ghoshpreetam18/smart_meter_using_arduino/IMG_20180408_132821.jpg

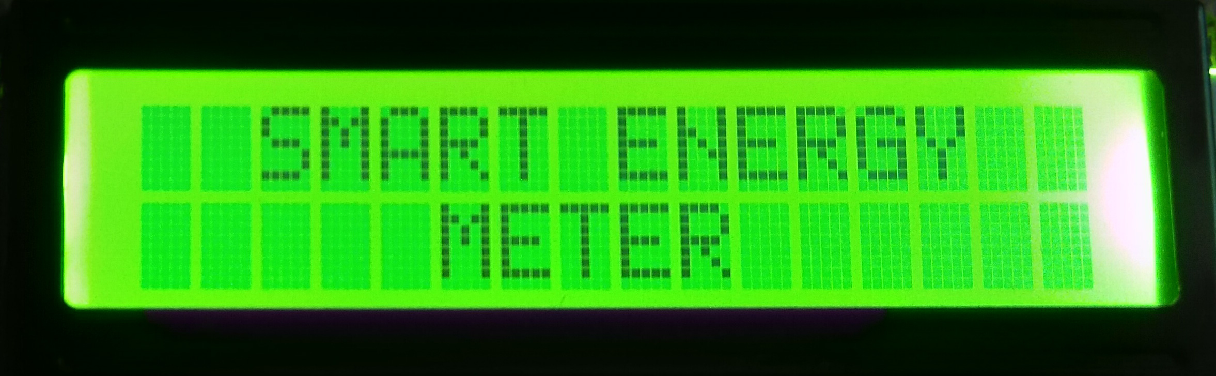
IMG_20180408_132821.jpg
