ghoshpreetam18/smart_meter_using_arduino/Screenshot (67).jpg

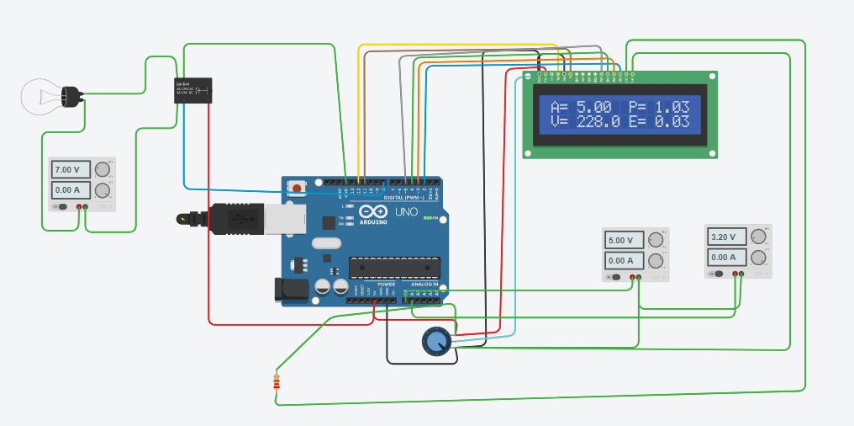
Screenshot (67).jpg
