ghoshpreetam18/smart_meter_using_arduino/Voltage Sensing Circuit.jpg

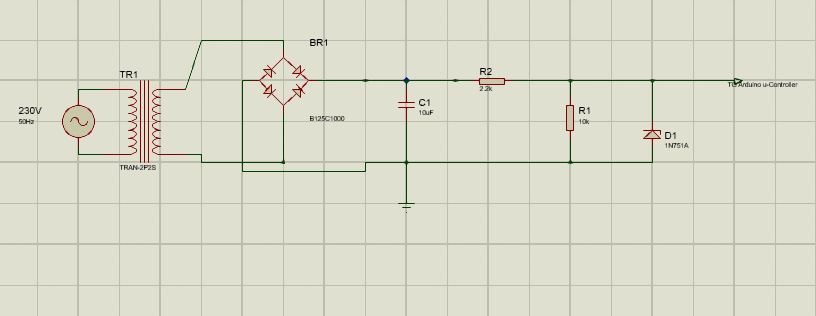
Voltage Sensing Circuit.jpg
