ghoshpreetam18/smart_meter_using_arduino/time_adjustment.ino

unsigned long time;

void setup(){
  Serial.begin(9600);
}
void loop(){
  Serial.print("Time: ");
  time = millis();

  Serial.println(time);    //prints time since program started
  delay(1000);             // wait a second so as not to send massive amounts of data
}
